dulsaragimhana/Smart-Timetable/Hardware Design/PCB/LCD/3D/Module 20x4 LCD Display PIN Configuration,Commands,Black on White.jpg

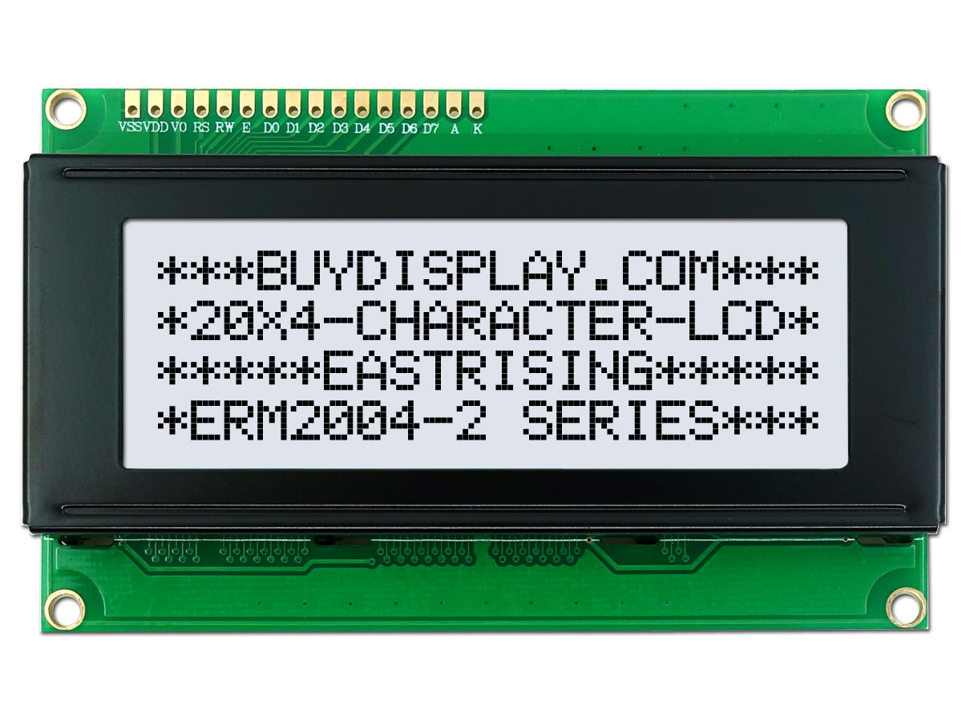
Hardware Design/PCB/LCD/3D/Module 20x4 LCD Display PIN Configuration,Commands,Black on White.jpg
