dulsaragimhana/Smart-Timetable/Hardware Design/PCB/LCD/3D/LCD Module 20x4 Display Datasheet Character,HD44780,Black on YG.jpg

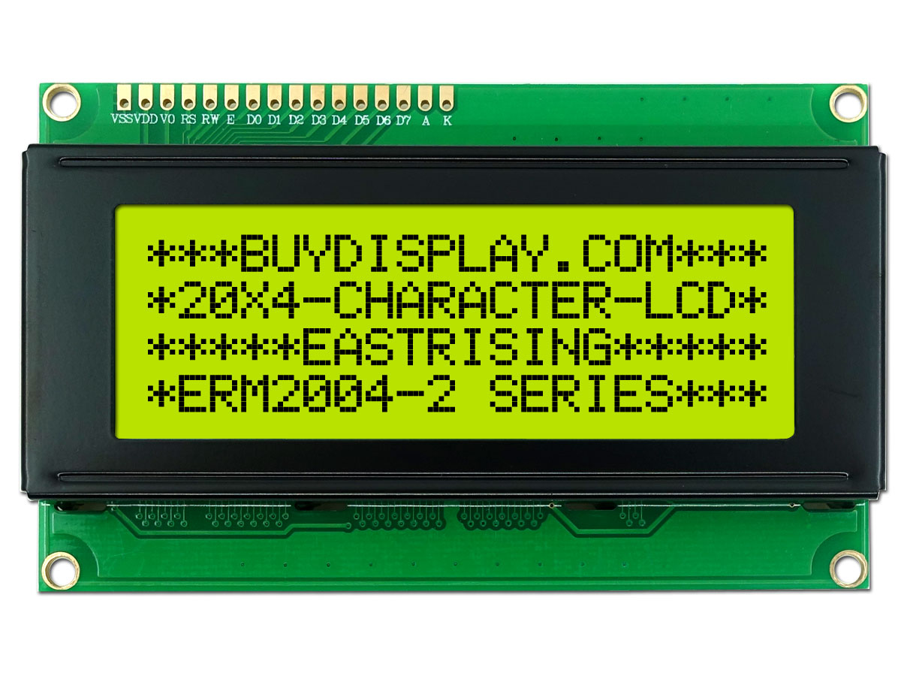
Hardware Design/PCB/LCD/3D/LCD Module 20x4 Display Datasheet Character,HD44780,Black on YG.jpg
