dulsaragimhana/Smart-Timetable/README.md

# Smart-Timetable
An IoT based system to automatically assign teachers to  the free periods. Furthermore, developed it to pass the updated  timetables for the teachers via an SMS and to the classes via an IoT  device.
