dulsaragimhana/Smart-Timetable/Mechanical Design/Readme.txt

Assembly is the file name of our CAD design in above folder
