dulsaragimhana/Smart-Timetable/Hardware Design/Doc/Schematic.jpg

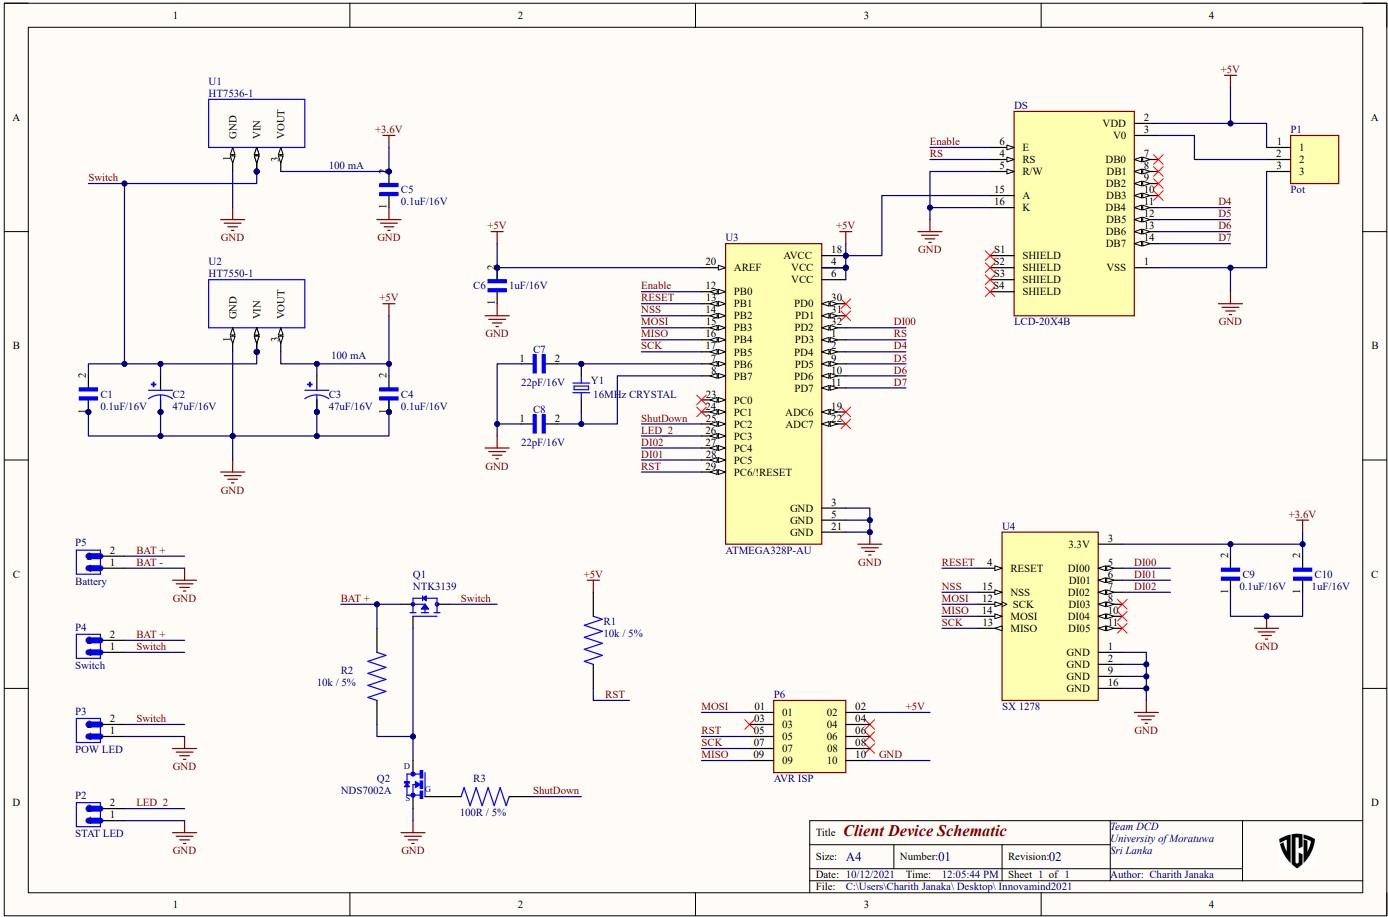
Hardware Design/Doc/Schematic.jpg
