dulsaragimhana/Smart-Timetable/Hardware Design/PCB/LCD/3D/Blue Character Display 20x4 LCD Module,Arduino,White LED Backlight.jpg

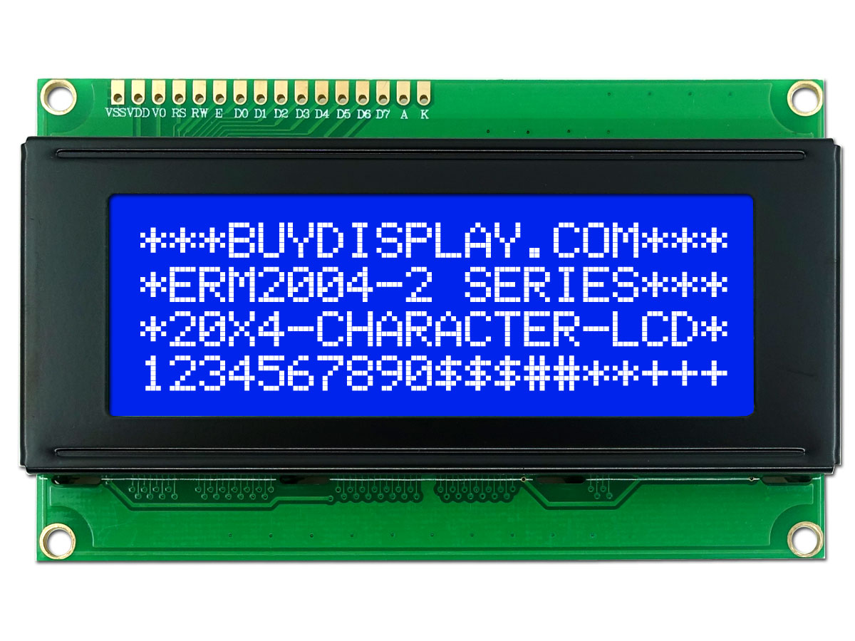
Hardware Design/PCB/LCD/3D/Blue Character Display 20x4 LCD Module,Arduino,White LED Backlight.jpg
