dulsaragimhana/Smart-Timetable/Hardware Design/PCB/LCD/3D/Connect White 20x4 Character Display to I2C Adapter Board with Dupont Wire.jpg

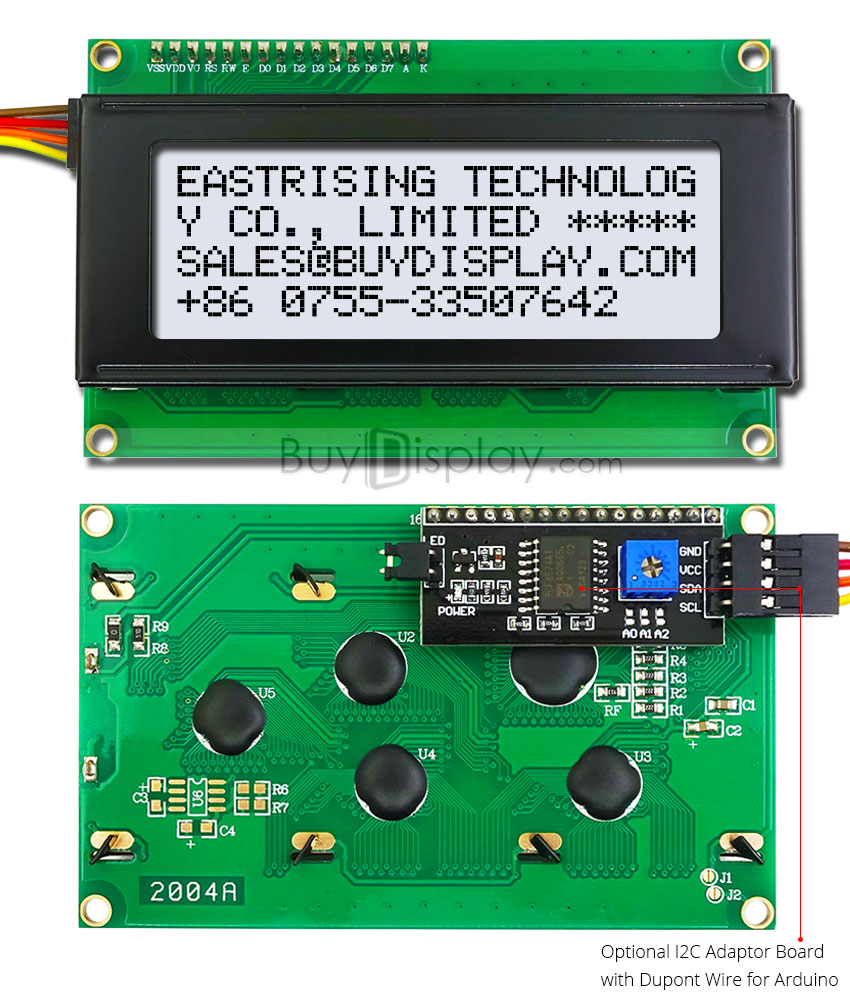
Hardware Design/PCB/LCD/3D/Connect White 20x4 Character Display to I2C Adapter Board with Dupont Wire.jpg
