dulsaragimhana/Smart-Timetable/Hardware Design/PCB/LCD/3D/ERM2004-2_3D Drawing.jpg

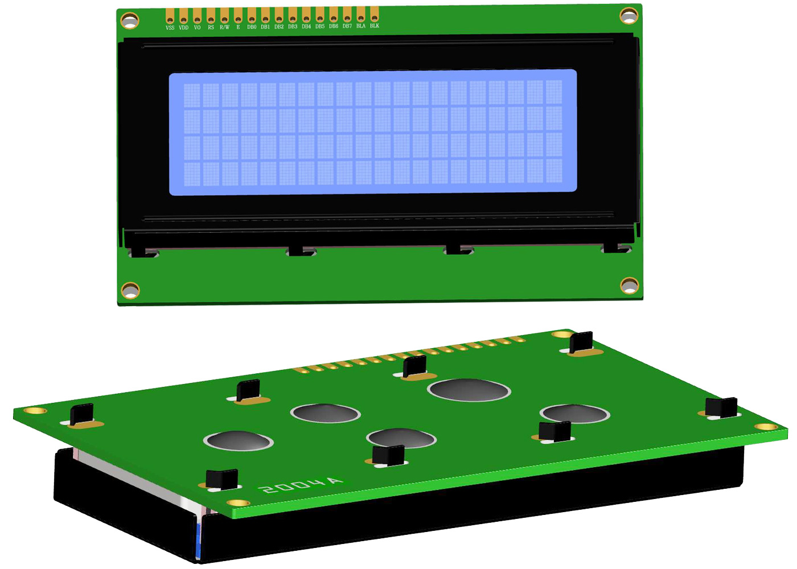
Hardware Design/PCB/LCD/3D/ERM2004-2_3D Drawing.jpg
