dulsaragimhana/Smart-Timetable/Hardware Design/PCB/LCD/3D/ERM2004-2_Bottom_View.jpg

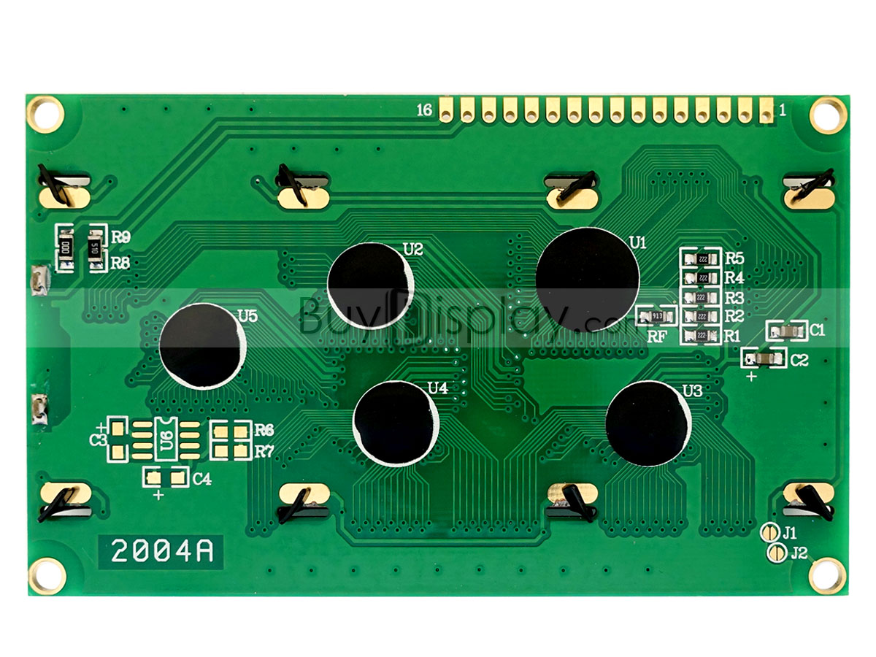
Hardware Design/PCB/LCD/3D/ERM2004-2_Bottom_View.jpg
