dulsaragimhana/Smart-Timetable/Mechanical Design/CAD/Antenna/Antenna1.png

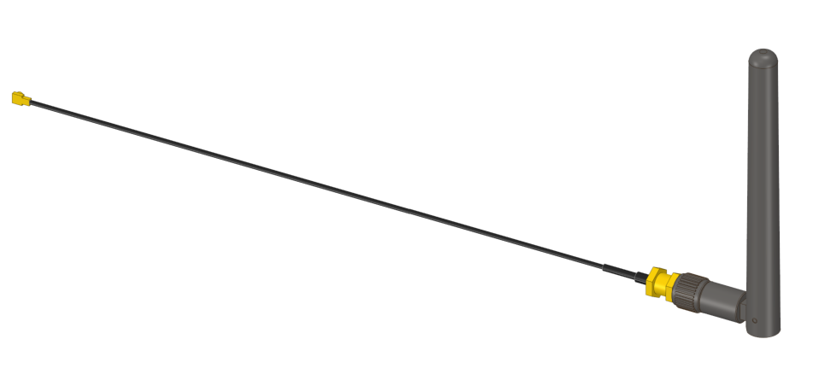
Mechanical Design/CAD/Antenna/Antenna1.png
