dulsaragimhana/Smart-Timetable/Mechanical Design/CAD/Antenna/Antenna2.png

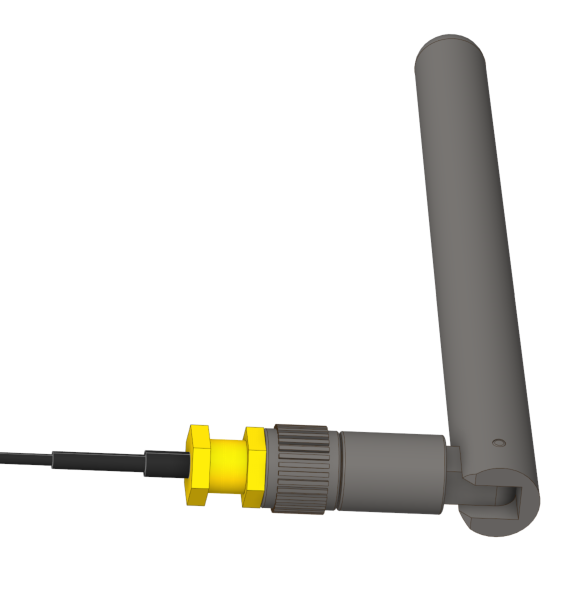
Mechanical Design/CAD/Antenna/Antenna2.png
