dulsaragimhana/Smart-Timetable/Mechanical Design/CAD/Pot2/Renderings/untitled.4.jpg

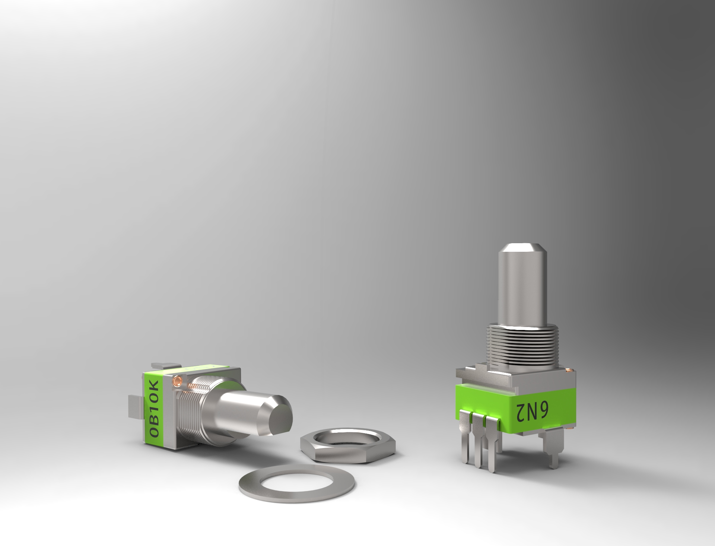
Mechanical Design/CAD/Pot2/Renderings/untitled.4.jpg
