dulsaragimhana/Smart-Timetable/Mechanical Design/CAD/PushButton/PushButton-Red.png

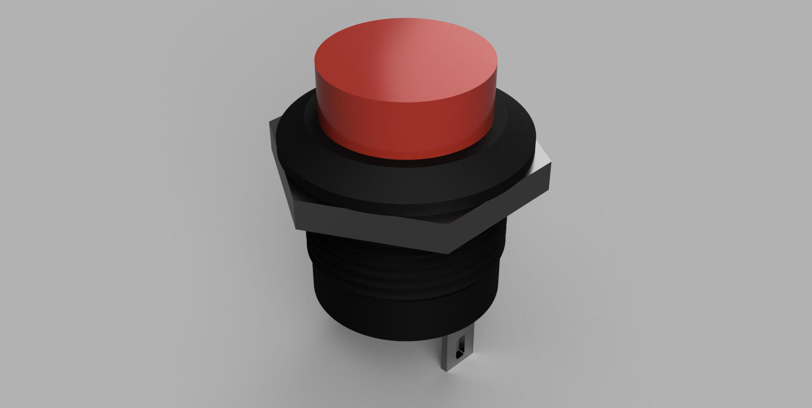
Mechanical Design/CAD/PushButton/PushButton-Red.png
