dulsaragimhana/Smart-Timetable/Hardware Design/PCB/100 Ohm/CRGCQ1206J100R.STEP

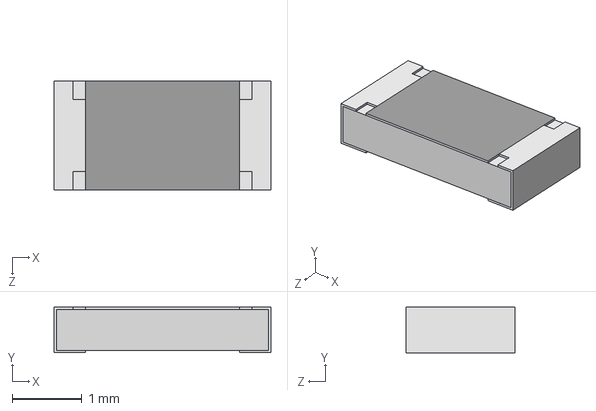
[picture p26: CAD file, 2023-03-04]
Hardware Design/PCB/100 Ohm/CRGCQ1206J100R.STEP
3.10 x 0.65 x 1.55 mm
