dulsaragimhana/Smart-Timetable/Hardware Design/PCB/16MHz/ECS-160-20-5PVX.STEP

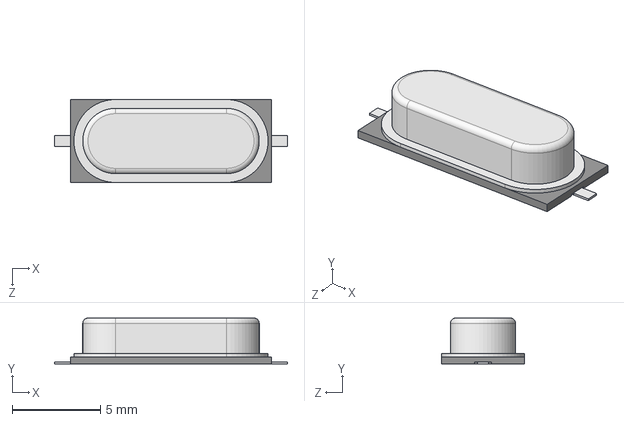
[picture p27: CAD file, 2023-03-04]
Hardware Design/PCB/16MHz/ECS-160-20-5PVX.STEP
13.2 x 2.60 x 4.70 mm
