dulsaragimhana/Smart-Timetable/Hardware Design/PCB/22pF/C1206C220F4HACAUTO.STEP

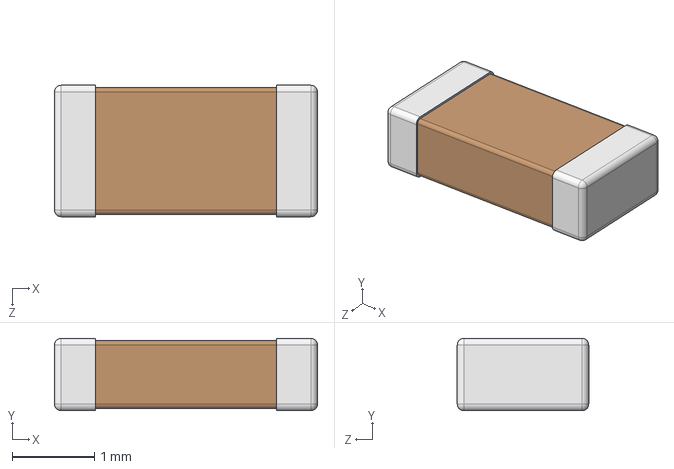
[picture p28: CAD file, 2023-03-04]
Hardware Design/PCB/22pF/C1206C220F4HACAUTO.STEP
3.20 x 0.88 x 1.60 mm
