dulsaragimhana/Smart-Timetable/Hardware Design/PCB/47uF/EEEFC0J470AR.STEP

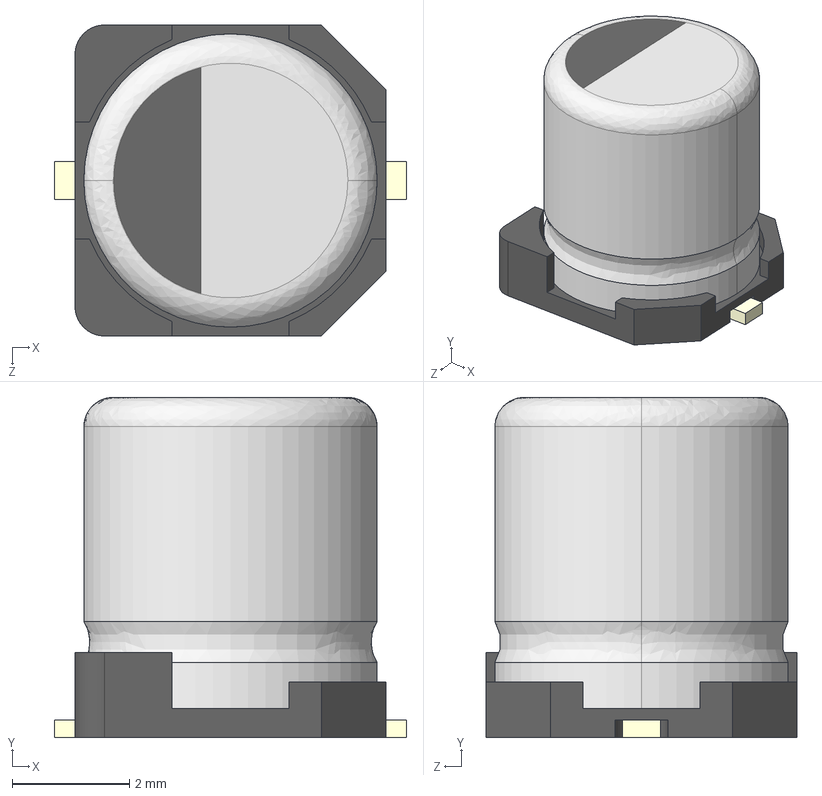
[picture p29: CAD file, 2023-03-04]
Hardware Design/PCB/47uF/EEEFC0J470AR.STEP
6.00 x 5.80 x 5.30 mm
