dulsaragimhana/Smart-Timetable/Hardware Design/PCB/Atmega328P/DIP/ATMEGA328P-PU--3DModel-STEP-56544.STEP

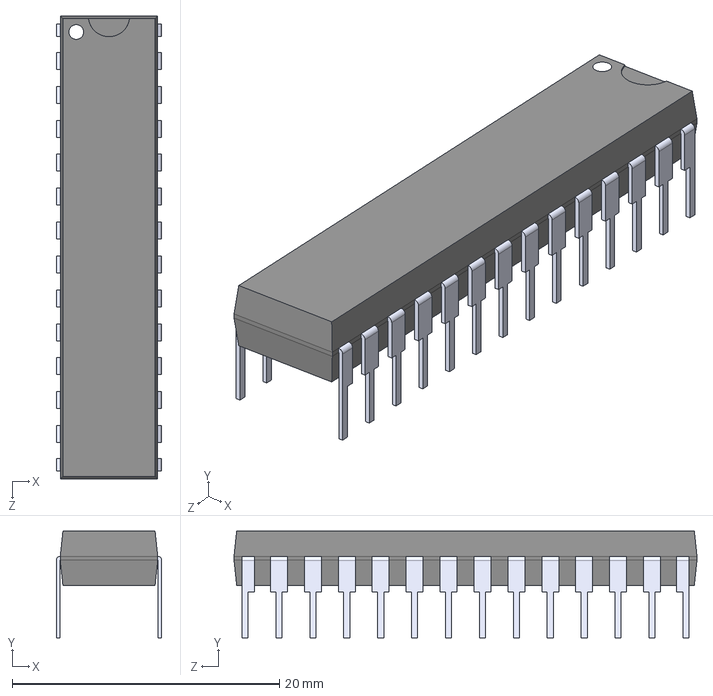
[picture p30: CAD file, 2023-03-04]
Hardware Design/PCB/Atmega328P/DIP/ATMEGA328P-PU--3DModel-STEP-56544.STEP
7.90 x 8.00 x 34.7 mm
