dulsaragimhana/Smart-Timetable/Hardware Design/PCB/Atmega328P/SMD/ATMEGA328P-AU.STEP

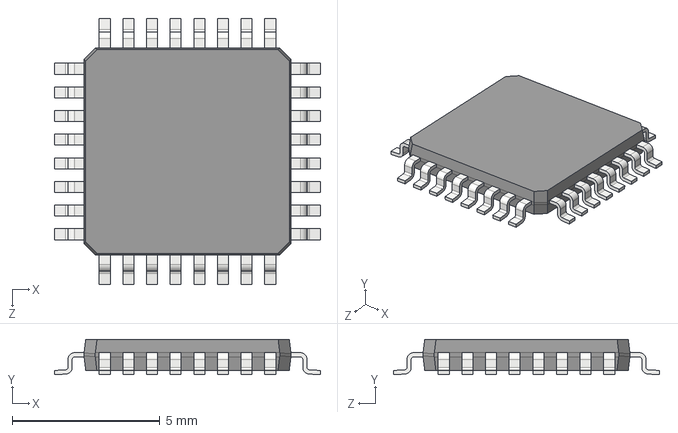
[picture p31: CAD file, 2023-03-04]
Hardware Design/PCB/Atmega328P/SMD/ATMEGA328P-AU.STEP
9.00 x 1.20 x 9.00 mm
