dulsaragimhana/Smart-Timetable/Hardware Design/PCB/Battery/9V_Batterie.STEP

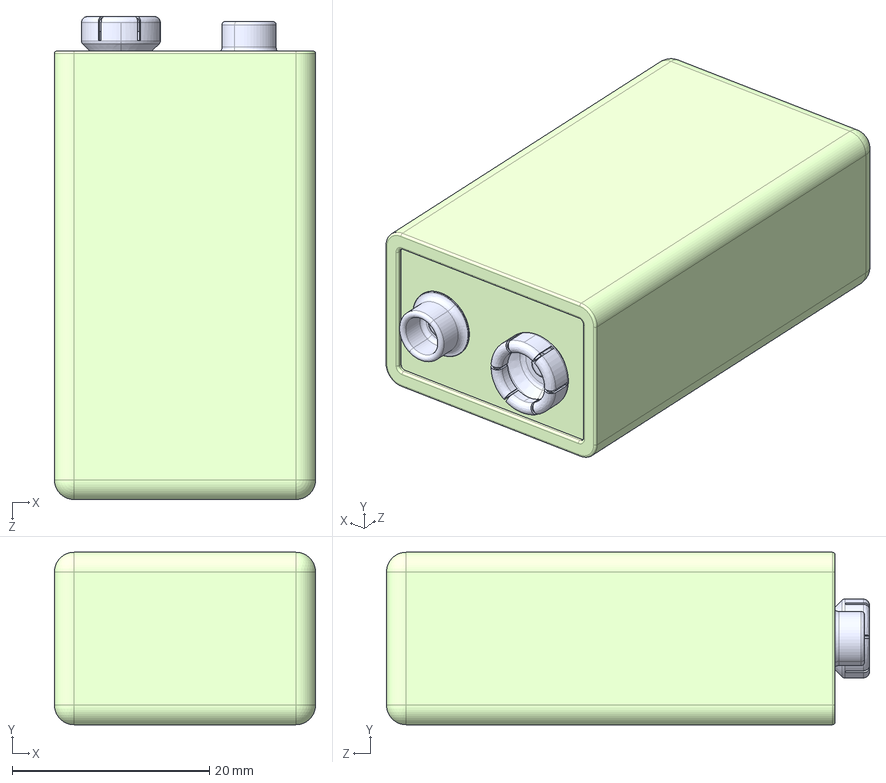
[picture p32: CAD file, 2023-03-04]
Hardware Design/PCB/Battery/9V_Batterie.STEP
26.5 x 17.5 x 49.0 mm
Corps Batterie
Connecteur femelle Batterie 9V
Connecteur male Batterie 9V
