dulsaragimhana/Smart-Timetable/Hardware Design/PCB/Header 2/S2B-XH-A(LF)(SN)--3DModel-STEP-56544.STEP

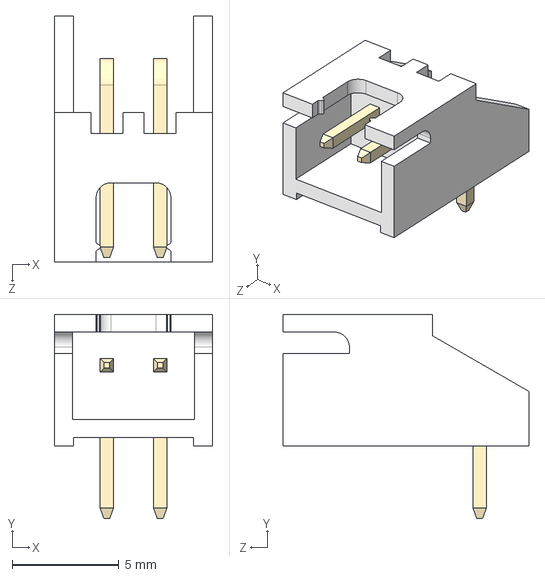
[picture p33: CAD file, 2023-03-04]
Hardware Design/PCB/Header 2/S2B-XH-A(LF)(SN)--3DModel-STEP-56544.STEP
7.40 x 9.55 x 11.5 mm
