dulsaragimhana/Smart-Timetable/Hardware Design/PCB/Header 3/S3B-XH-A-LF--SN---3DModel-STEP-56544.STEP

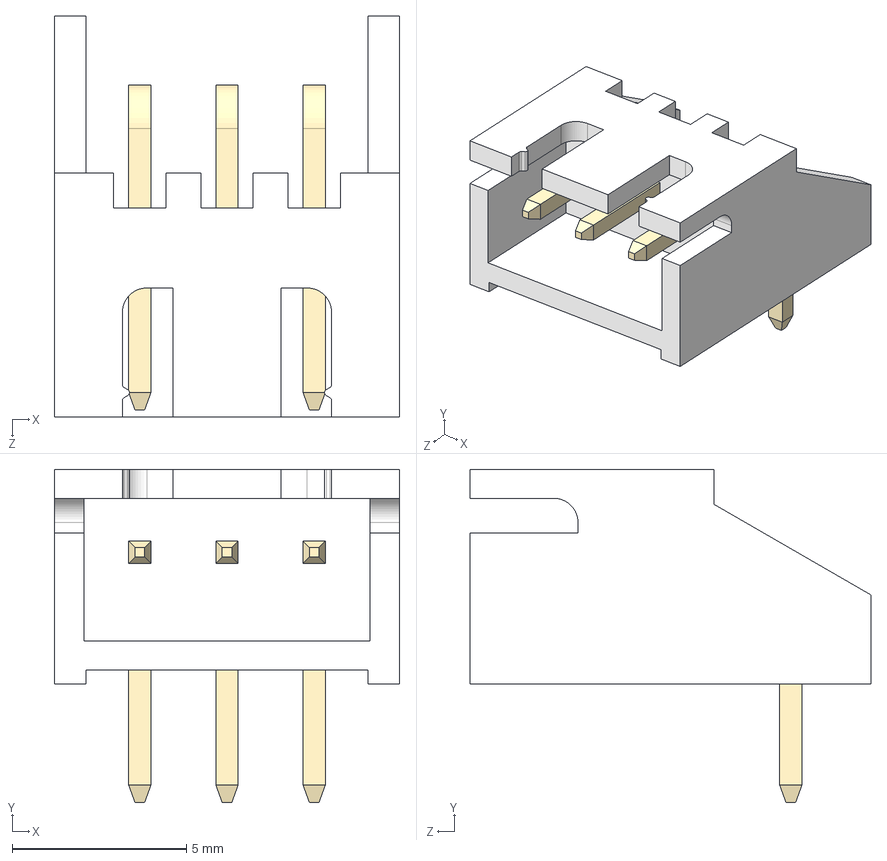
[picture p34: CAD file, 2023-03-04]
Hardware Design/PCB/Header 3/S3B-XH-A-LF--SN---3DModel-STEP-56544.STEP
9.90 x 9.55 x 11.5 mm
