dulsaragimhana/Smart-Timetable/Hardware Design/PCB/HT75xx/SOT-89.STEP

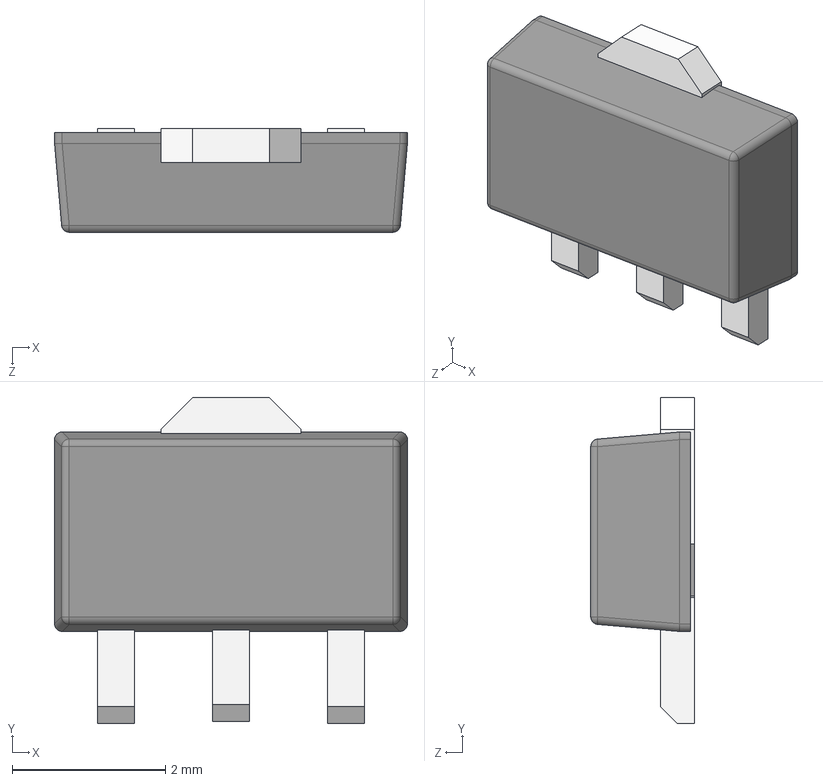
[picture p35: CAD file, 2023-03-04]
Hardware Design/PCB/HT75xx/SOT-89.STEP
4.60 x 4.25 x 1.35 mm
