dulsaragimhana/Smart-Timetable/Hardware Design/PCB/ISPHeader/TSW-105-05-L-D.STEP

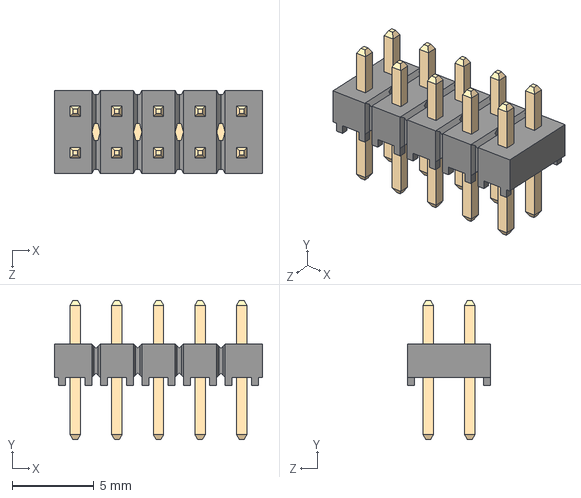
[picture p36: CAD file, 2023-03-04]
Hardware Design/PCB/ISPHeader/TSW-105-05-L-D.STEP
12.7 x 8.51 x 5.08 mm
_TSW-105-05-L-D_body.stp
_T-1S6-21-TSW-1-05-5-D.stp
