dulsaragimhana/Smart-Timetable/Hardware Design/PCB/LCD/lcd20x4hd44780.stp

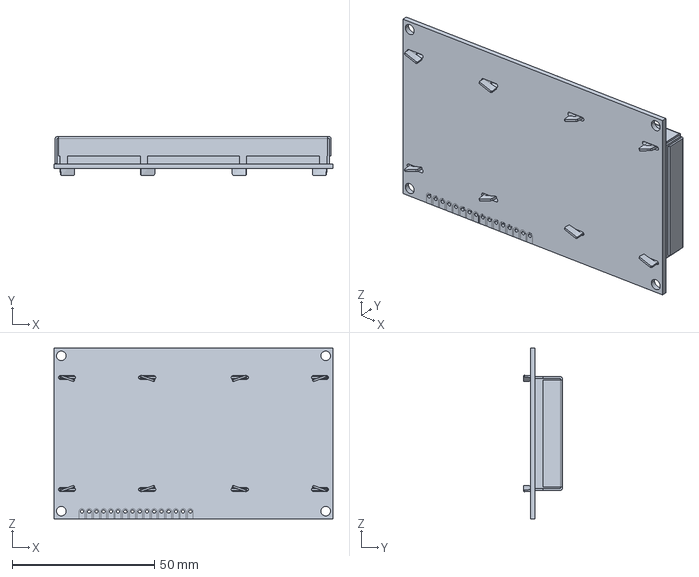
[picture p37: CAD file, 2023-03-04]
Hardware Design/PCB/LCD/lcd20x4hd44780.stp
98.1 x 13.7 x 59.9 mm
