dulsaragimhana/Smart-Timetable/Hardware Design/PCB/LCDHeader/SSW-116-22-G-S.STEP

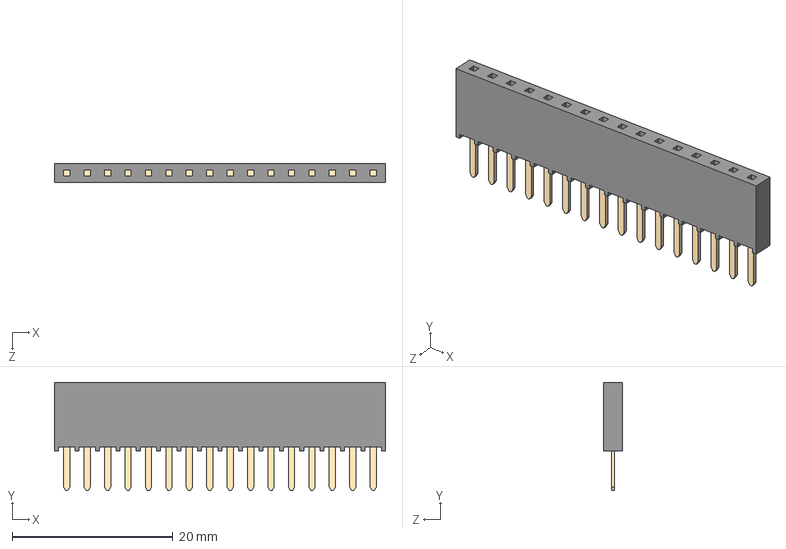
[picture p38: CAD file, 2023-03-04]
Hardware Design/PCB/LCDHeader/SSW-116-22-G-S.STEP
41.1 x 13.4 x 2.41 mm
_T1SSW-116-22-G-S.stp
_P2SSW-116-22-G-S.stp
