dulsaragimhana/Smart-Timetable/Hardware Design/PCB/LoRa 02/LoRa_Module_RA-02_AiThinker.step

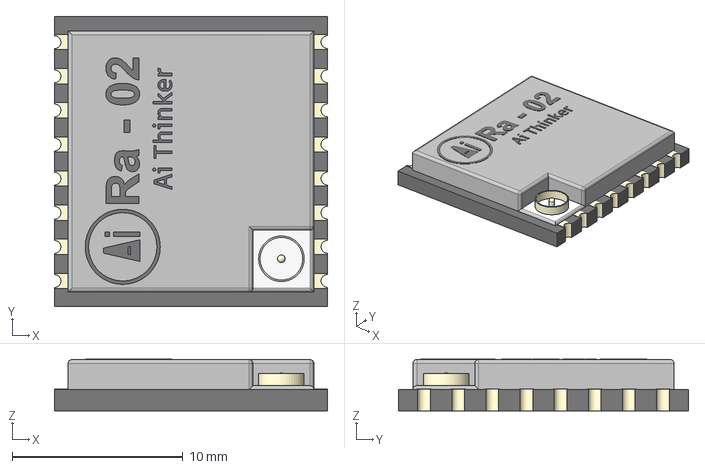
[picture p39: CAD file, 2023-03-04]
Hardware Design/PCB/LoRa 02/LoRa_Module_RA-02_AiThinker.step
16.0 x 17.0 x 3.03 mm
