dulsaragimhana/Smart-Timetable/Hardware Design/PCB/NMos/NDS7002A.STEP

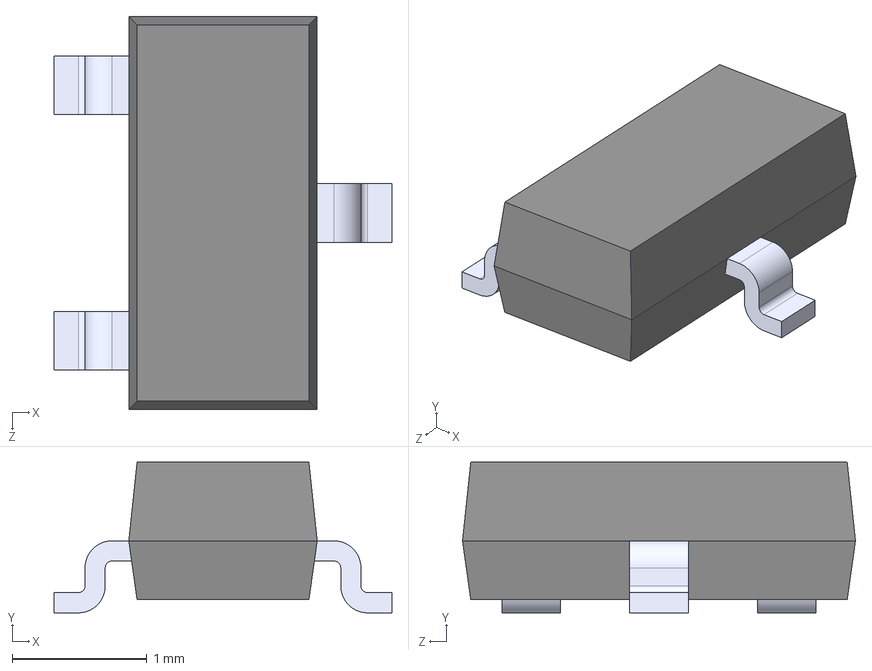
[picture p40: CAD file, 2023-03-04]
Hardware Design/PCB/NMos/NDS7002A.STEP
2.51 x 1.12 x 2.92 mm
