dulsaragimhana/Smart-Timetable/Hardware Design/PCB/PMos/IRF9540/IRF9540NSTRLPBF.STEP

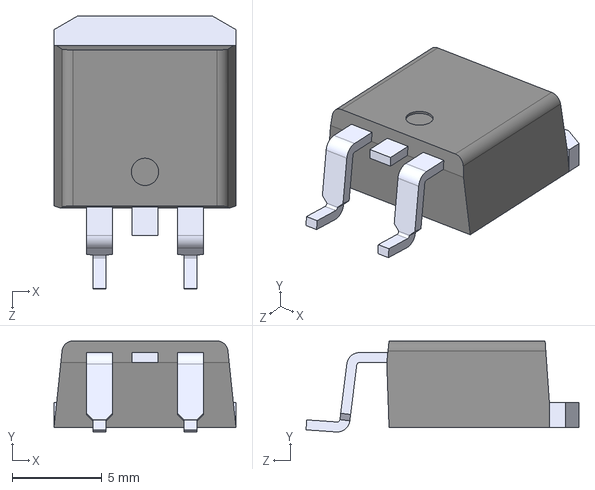
[picture p41: CAD file, 2023-03-04]
Hardware Design/PCB/PMos/IRF9540/IRF9540NSTRLPBF.STEP
10.2 x 5.08 x 15.2 mm
