dulsaragimhana/Smart-Timetable/Hardware Design/PCB/PMos/NTK3139PT1G.STEP

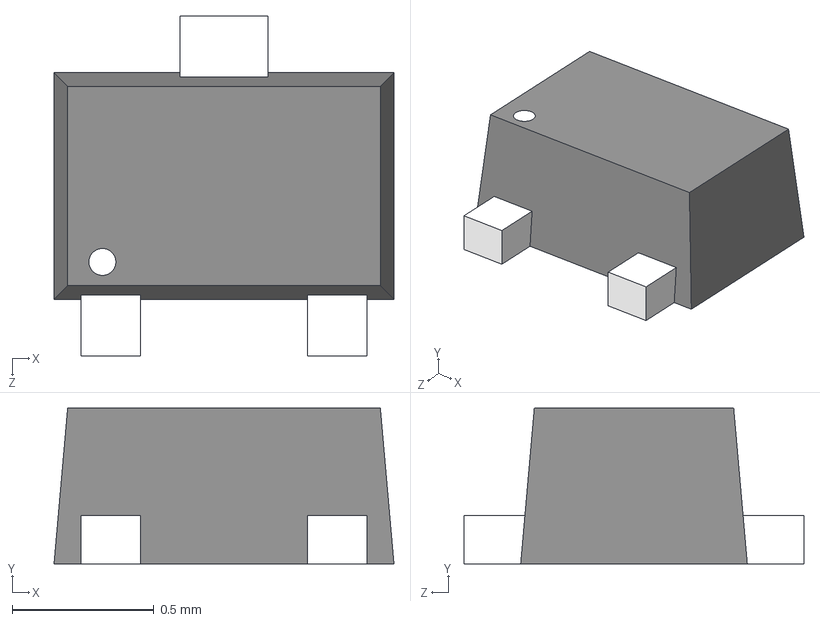
[picture p42: CAD file, 2023-03-04]
Hardware Design/PCB/PMos/NTK3139PT1G.STEP
1.20 x 0.55 x 1.20 mm
