dulsaragimhana/Smart-Timetable/Hardware Design/PCB/Switch/1101M2S3CQE2--3DModel-STEP-56544.STEP

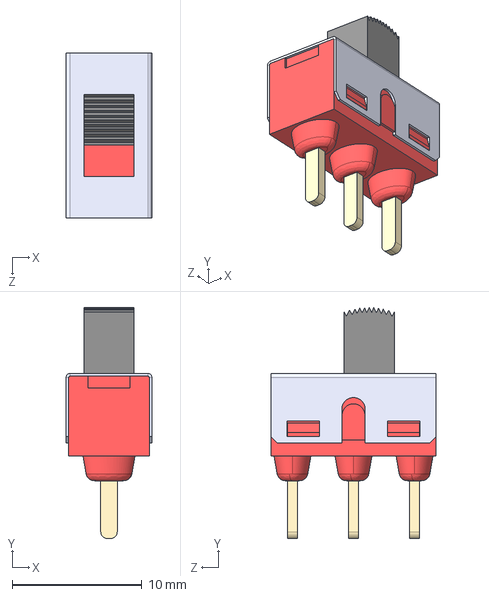
[picture p43: CAD file, 2023-03-04]
Hardware Design/PCB/Switch/1101M2S3CQE2--3DModel-STEP-56544.STEP
6.60 x 17.8 x 12.7 mm
