dulsaragimhana/Smart-Timetable/Mechanical Design/CAD/Antenna/Raspberry Pi CM4 Antenna.stp

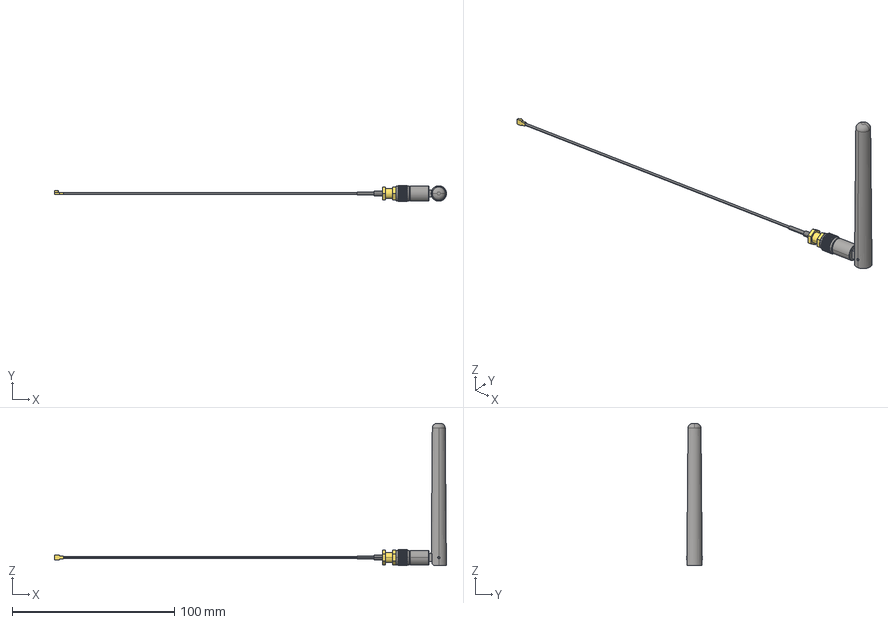
[picture p44: CAD file, 2023-03-04]
Mechanical Design/CAD/Antenna/Raspberry Pi CM4 Antenna.stp
241.5 x 10.0 x 87.7 mm
Antenna body
Antenna base
Threads
Bolt Geometry
Nut
Cable
Coax Connector
