dulsaragimhana/Smart-Timetable/Mechanical Design/CAD/BATTERY PACK B/BATTERY PACK BASE.STEP

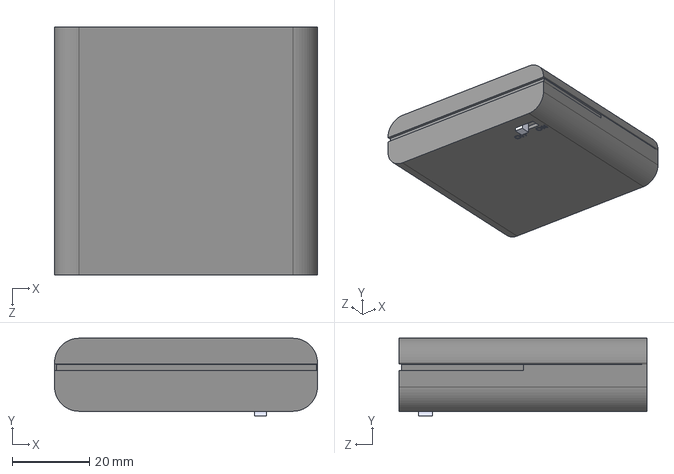
[picture p45: CAD file, 2023-03-04]
Mechanical Design/CAD/BATTERY PACK B/BATTERY PACK BASE.STEP
68.1 x 20.1 x 64.2 mm
