dulsaragimhana/Smart-Timetable/Mechanical Design/CAD/GreenLEDCap.SLDPRT

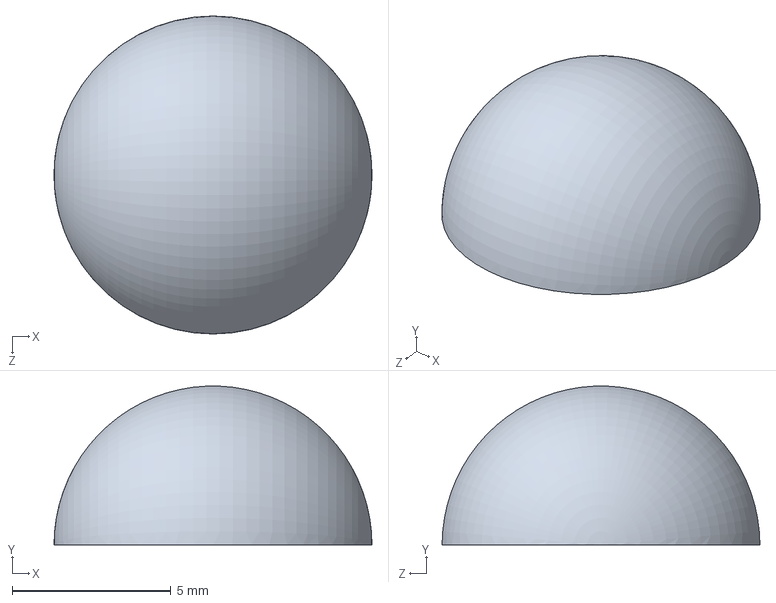
[picture p46: CAD file, 2023-03-04]
Mechanical Design/CAD/GreenLEDCap.SLDPRT
10.0 x 4.99 x 10.0 mm
