dulsaragimhana/Smart-Timetable/Mechanical Design/CAD/LED/LED_D5.0mm_RED.step

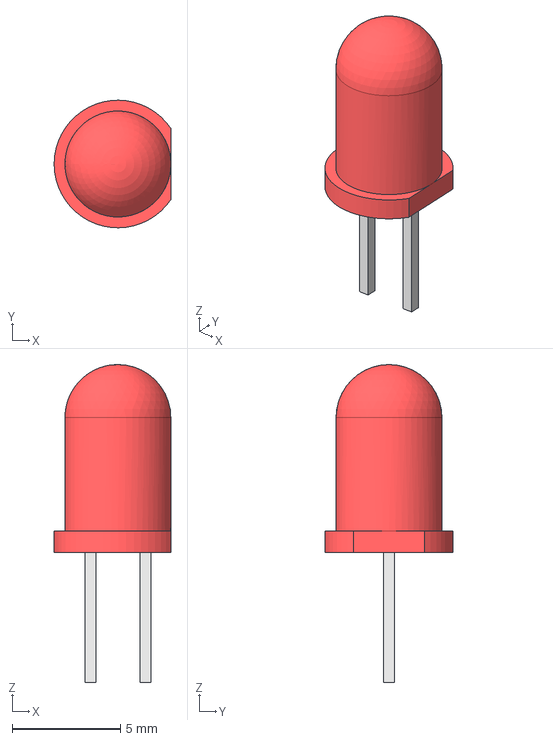
[picture p47: CAD file, 2023-03-04]
Mechanical Design/CAD/LED/LED_D5.0mm_RED.step
5.40 x 5.90 x 14.7 mm
