dulsaragimhana/Smart-Timetable/Mechanical Design/CAD/Pot/PotentiometerB10K.step

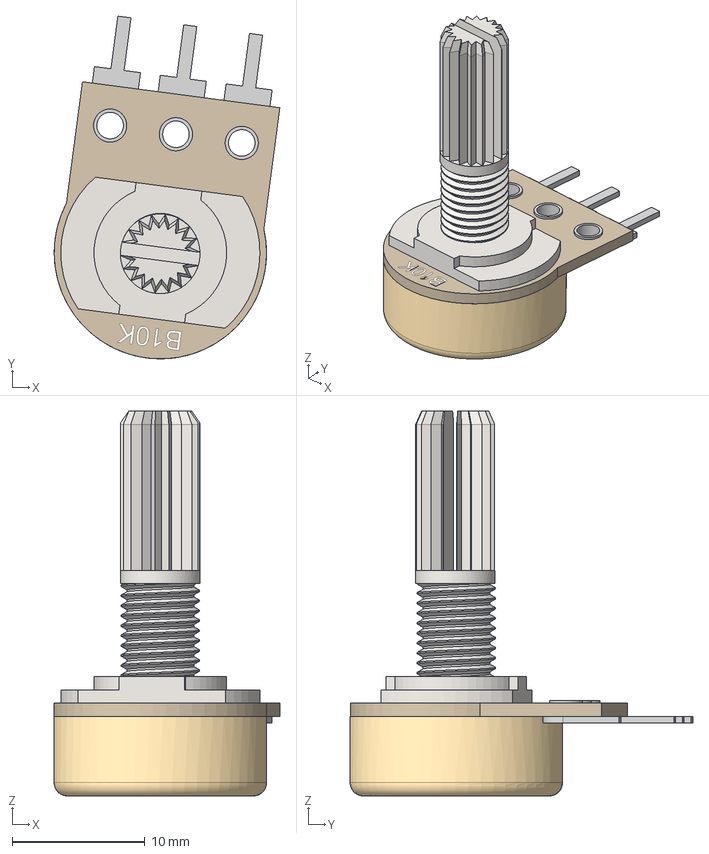
[picture p48: CAD file, 2023-03-04]
Mechanical Design/CAD/Pot/PotentiometerB10K.step
17.0 x 25.8 x 29.0 mm
Shaft
ScrewBase
Board
Pin1
Pin2
Pin3
Casing
