dulsaragimhana/Smart-Timetable/Mechanical Design/CAD/PotKnob/Knob.step

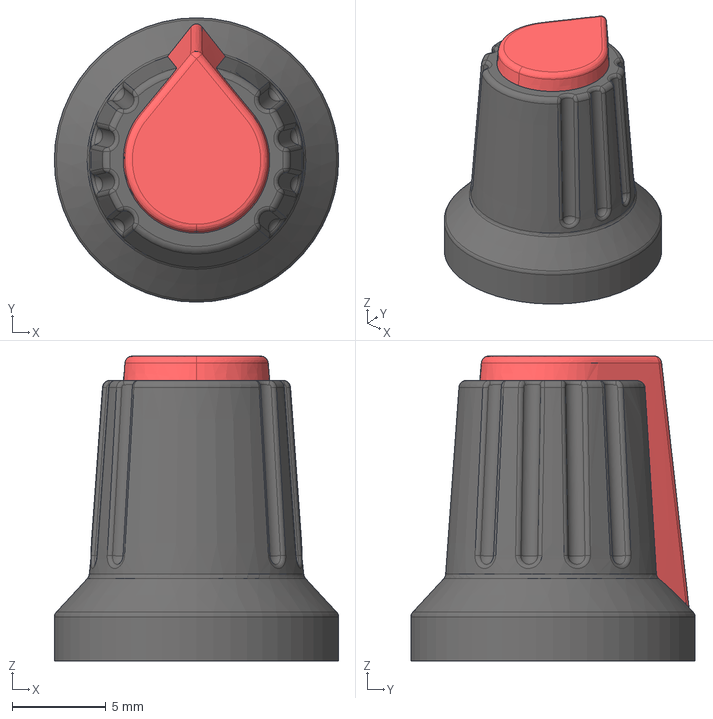
[picture p49: CAD file, 2023-03-04]
Mechanical Design/CAD/PotKnob/Knob.step
15.2 x 15.2 x 16.3 mm
Rouge
Extérieur
