dulsaragimhana/Smart-Timetable/Mechanical Design/CAD/BATTERY PACK B/BATTERY PACK.STEP

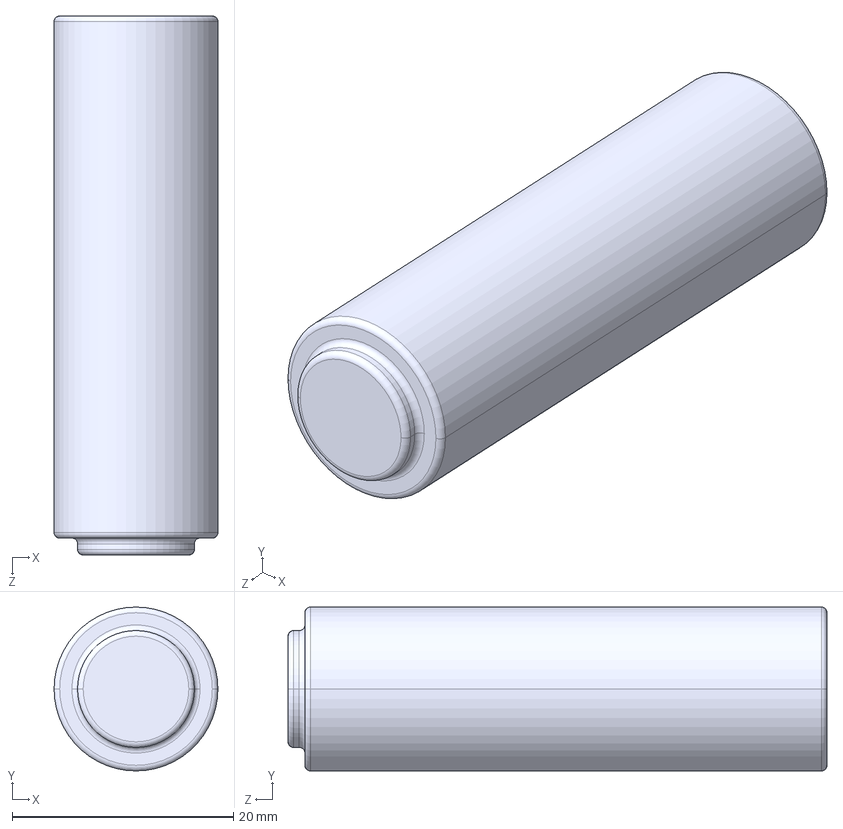
[picture p50: CAD file, 2023-03-04]
Mechanical Design/CAD/BATTERY PACK B/BATTERY PACK.STEP
14.8 x 14.8 x 48.7 mm
