dulsaragimhana/Smart-Timetable/Mechanical Design/CAD/PushButton/PushButtonRed v8.step

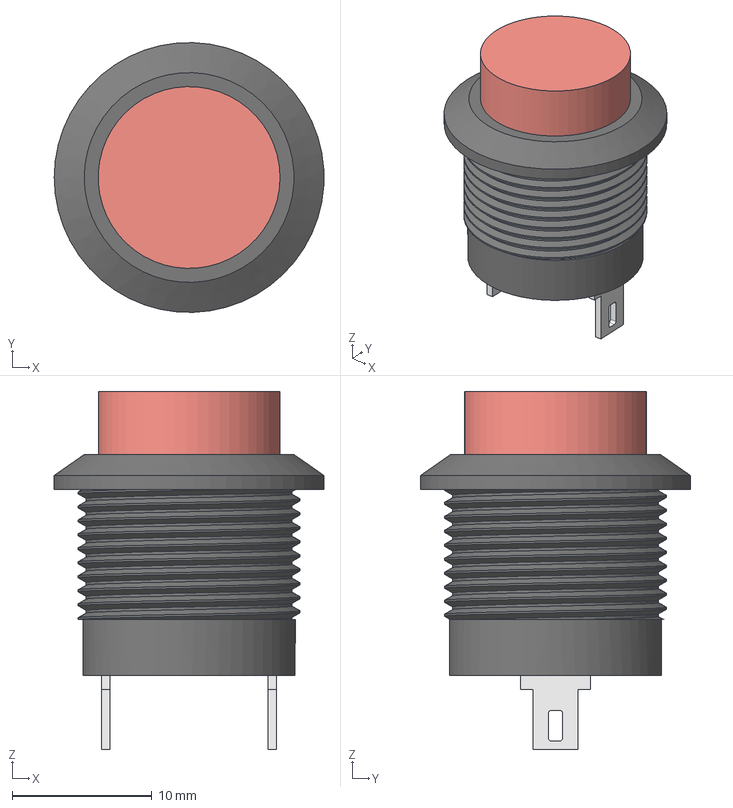
[picture p51: CAD file, 2023-03-04]
Mechanical Design/CAD/PushButton/PushButtonRed v8.step
19.3 x 19.3 x 25.6 mm
ButtonBody
Button
Connector x 2
