dulsaragimhana/Smart-Timetable/Mechanical Design/CAD/BATTERY PACK B/BATTERY PACK COVER.STEP

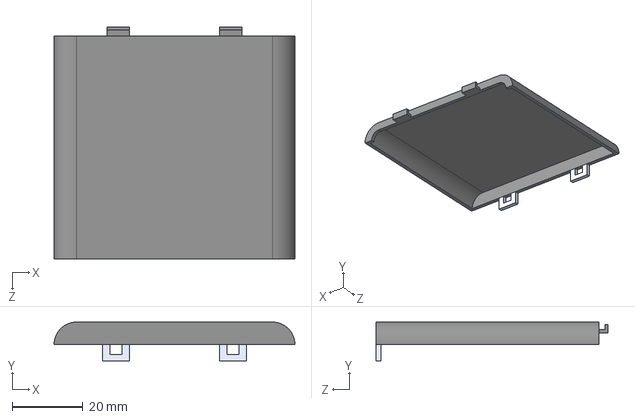
[picture p52: CAD file, 2023-03-04]
Mechanical Design/CAD/BATTERY PACK B/BATTERY PACK COVER.STEP
68.1 x 11.0 x 65.5 mm
