dulsaragimhana/Smart-Timetable/Mechanical Design/CAD/M4 x 20mm.step

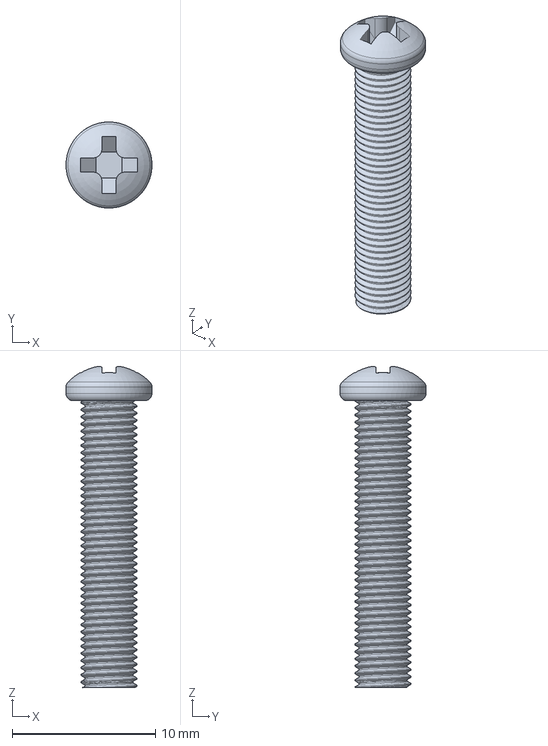
[picture p53: CAD file, 2023-03-04]
Mechanical Design/CAD/M4 x 20mm.step
6.00 x 6.00 x 22.4 mm
