dulsaragimhana/Smart-Timetable/Mechanical Design/CAD/Pot2/KA Type Shaft.STEP

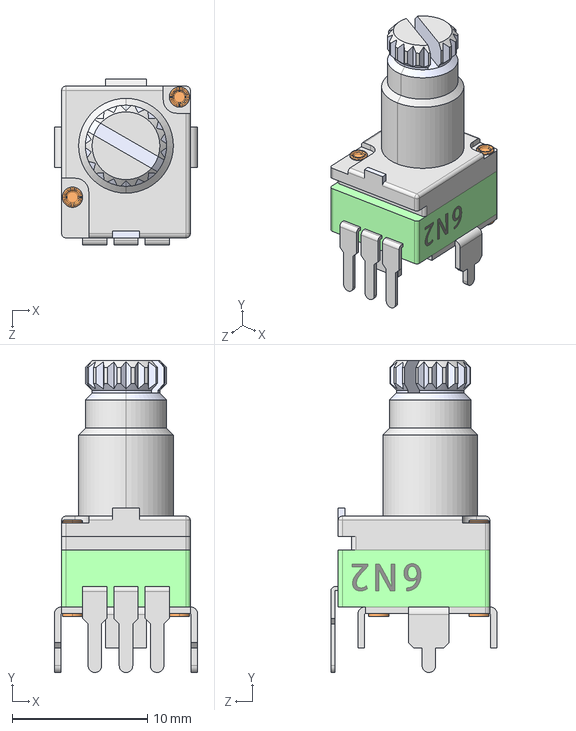
[picture p54: CAD file, 2023-03-04]
Mechanical Design/CAD/Pot2/KA Type Shaft.STEP
10.6 x 23.1 x 12.3 mm
