dulsaragimhana/Smart-Timetable/Mechanical Design/CAD/PushButton/PushButtonRed-WithNut.step

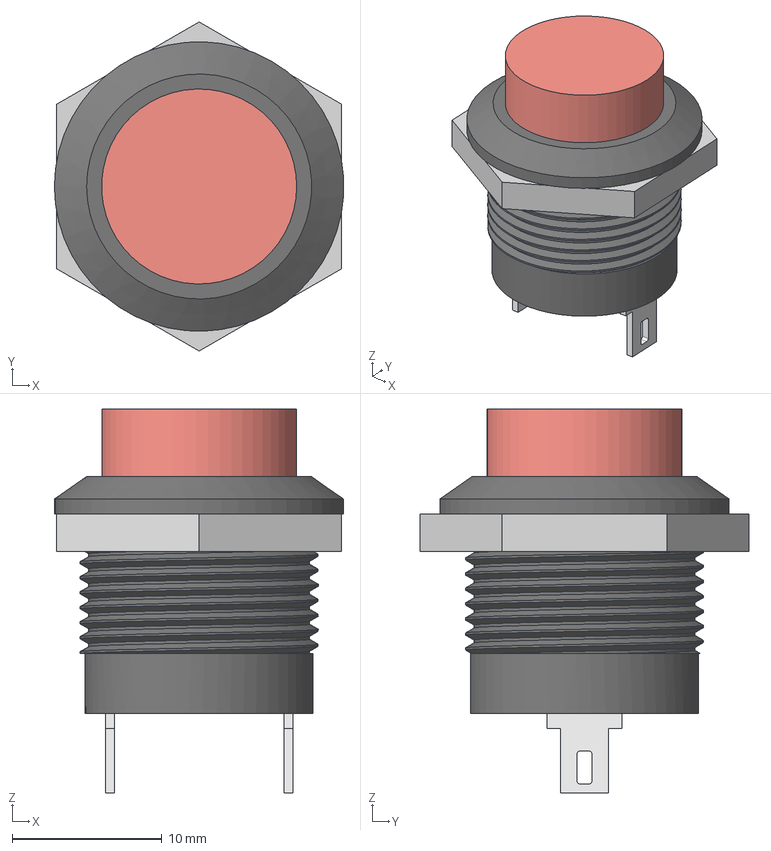
[picture p55: CAD file, 2023-03-04]
Mechanical Design/CAD/PushButton/PushButtonRed-WithNut.step
19.3 x 21.9 x 25.6 mm
ButtonBody
Button
Connector x 2
Nut
