dulsaragimhana/Smart-Timetable/Mechanical Design/CAD/M4 x 10mm.step

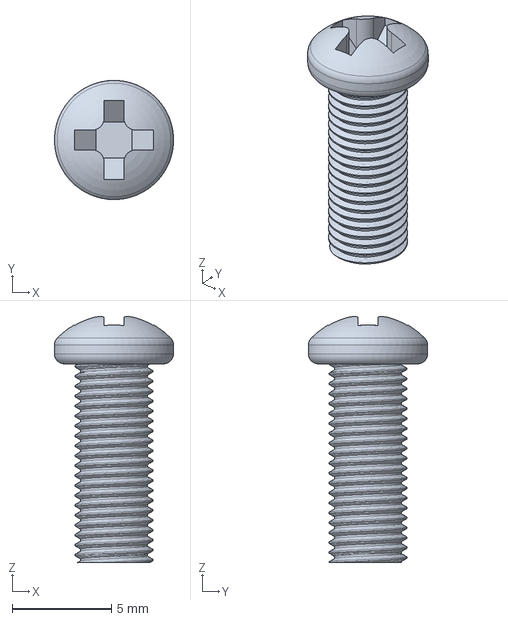
[picture p56: CAD file, 2023-03-04]
Mechanical Design/CAD/M4 x 10mm.step
6.00 x 6.00 x 12.4 mm
