dulsaragimhana/Smart-Timetable/Mechanical Design/CAD/Pot2/Potentiometer.STEP

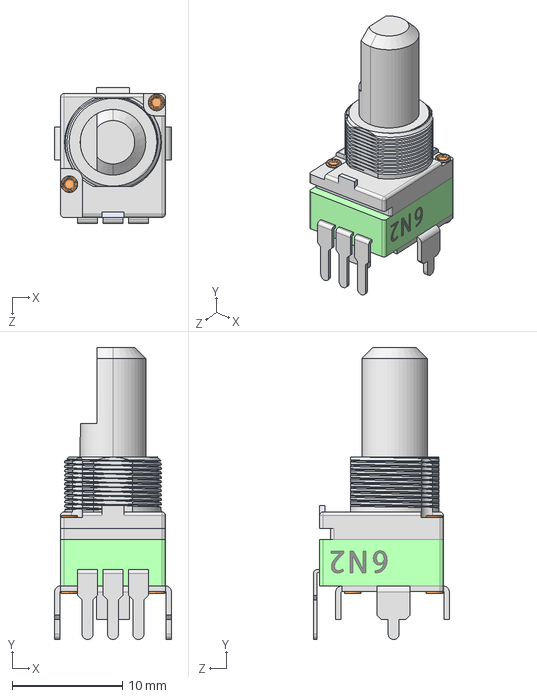
[picture p57: CAD file, 2023-03-04]
Mechanical Design/CAD/Pot2/Potentiometer.STEP
10.6 x 26.5 x 12.3 mm
