dulsaragimhana/Smart-Timetable/Mechanical Design/CAD/BatteryCover.SLDPRT

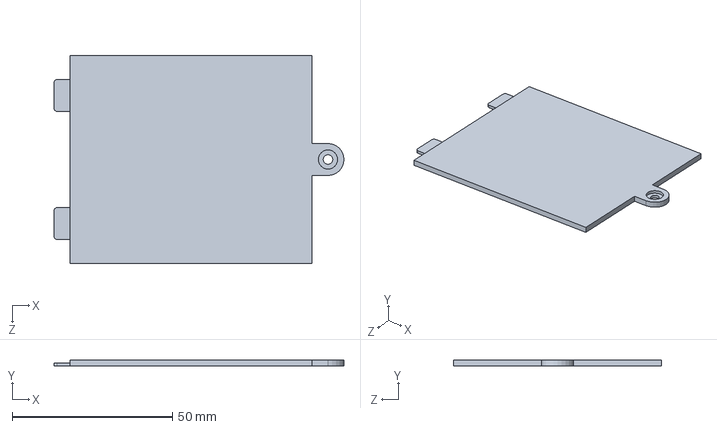
[picture p58: CAD file, 2023-03-04]
Mechanical Design/CAD/BatteryCover.SLDPRT
90.5 x 2.00 x 64.8 mm
