dulsaragimhana/Smart-Timetable/Mechanical Design/CAD/FrontFace.SLDPRT

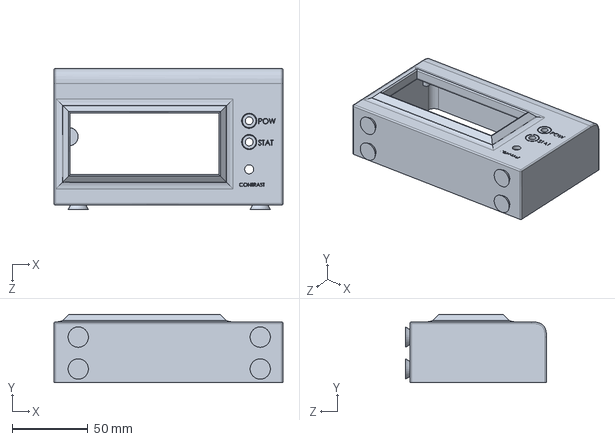
[picture p59: CAD file, 2023-03-04]
Mechanical Design/CAD/FrontFace.SLDPRT
151.0 x 45.0 x 93.0 mm
