dulsaragimhana/Smart-Timetable/(list of files, cad)

Other CAD files:
Hardware Design/PCB/10k/CRGCQ1206J10K.STEP
Mechanical Design/CAD/LED/LED_D5.0mm_BLUE.step
Mechanical Design/CAD/RedLEDCap.SLDPRT
Mechanical Design/CAD/LED/LED_D5.0mm_GREEN.step
Mechanical Design/CAD/LED/LED_D5.0mm_ORANGE.step
Mechanical Design/CAD/LED/LED_D5.0mm_CLEAR.step
Mechanical Design/CAD/LED/LED_D5.0mm_WHITE.step
Mechanical Design/CAD/LED/LED_D5.0mm_YELLOW.step
Hardware Design/PCB/ISPHeader/TSW-105-05-L-D.stp
Hardware Design/PCB/LCDHeader/SSW-116-22-G-S.stp
Mechanical Design/CAD/BATTERY PACK B/BATTERY PACK BASE.IGS
Mechanical Design/CAD/BATTERY PACK B/BATTERY PACK BASE.SLDPRT
Mechanical Design/CAD/BATTERY PACK B/BATTERY PACK COVER.IGS
Mechanical Design/CAD/BATTERY PACK B/BATTERY PACK COVER.SLDPRT
Mechanical Design/CAD/BATTERY PACK B/BATTERY PACK COVER.STL
Mechanical Design/CAD/BATTERY PACK B/BATTERY PACK.IGS
Mechanical Design/CAD/BATTERY PACK B/BATTERY PACK.SLDPRT
Mechanical Design/CAD/BATTERY PACK B/BATTERY PACK.STL
Mechanical Design/CAD/Pot/PotentiometerB10K.f3d
Mechanical Design/CAD/Pot/PotentiometerB10K.iges
Mechanical Design/CAD/Pot/PotentiometerB10K.stl
Mechanical Design/CAD/Pot2/KA Type Shaft.SLDPRT
Mechanical Design/CAD/Pot2/Nut.SLDPRT
Mechanical Design/CAD/Pot2/Nut.STEP
Mechanical Design/CAD/Pot2/Potentiometer.IGS
Mechanical Design/CAD/Pot2/Potentiometer.SLDPRT
Mechanical Design/CAD/Pot2/Potentiometer.STL
Mechanical Design/CAD/Pot2/Potentiometer.x_t
Mechanical Design/CAD/Pot2/Washer 9,0 x 14,0 x 0,5.SLDPRT
Mechanical Design/CAD/Pot2/Washer 9,0 x 14,0 x 0,5.STEP
Mechanical Design/CAD/PotKnob/Knob.f3d
Mechanical Design/CAD/PotKnob/Knob.iges
Mechanical Design/CAD/PushButton/PushButtonRed v9.f3d
Mechanical Design/CAD/PushButton/PushButtonRed-Nut.step
