dulsaragimhana/Smart-Timetable/Hardware Design/Doc/Schematic.pdf

# HT7536-1 GND

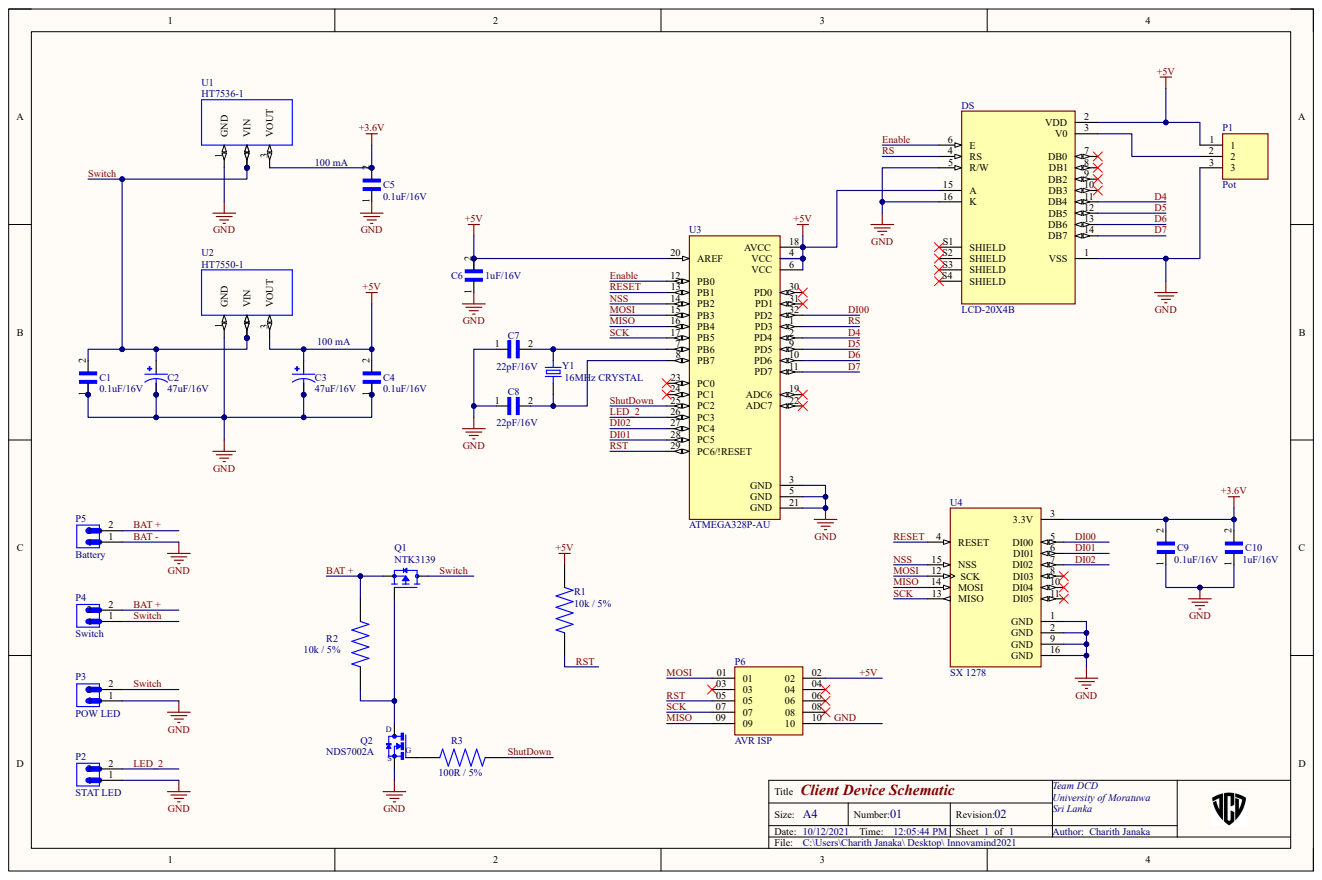
[picture p60: page 1]
