dulsaragimhana/Smart-Timetable/Hardware Design/PCB/InnovaMind2021/InnovaMind2021.pdf

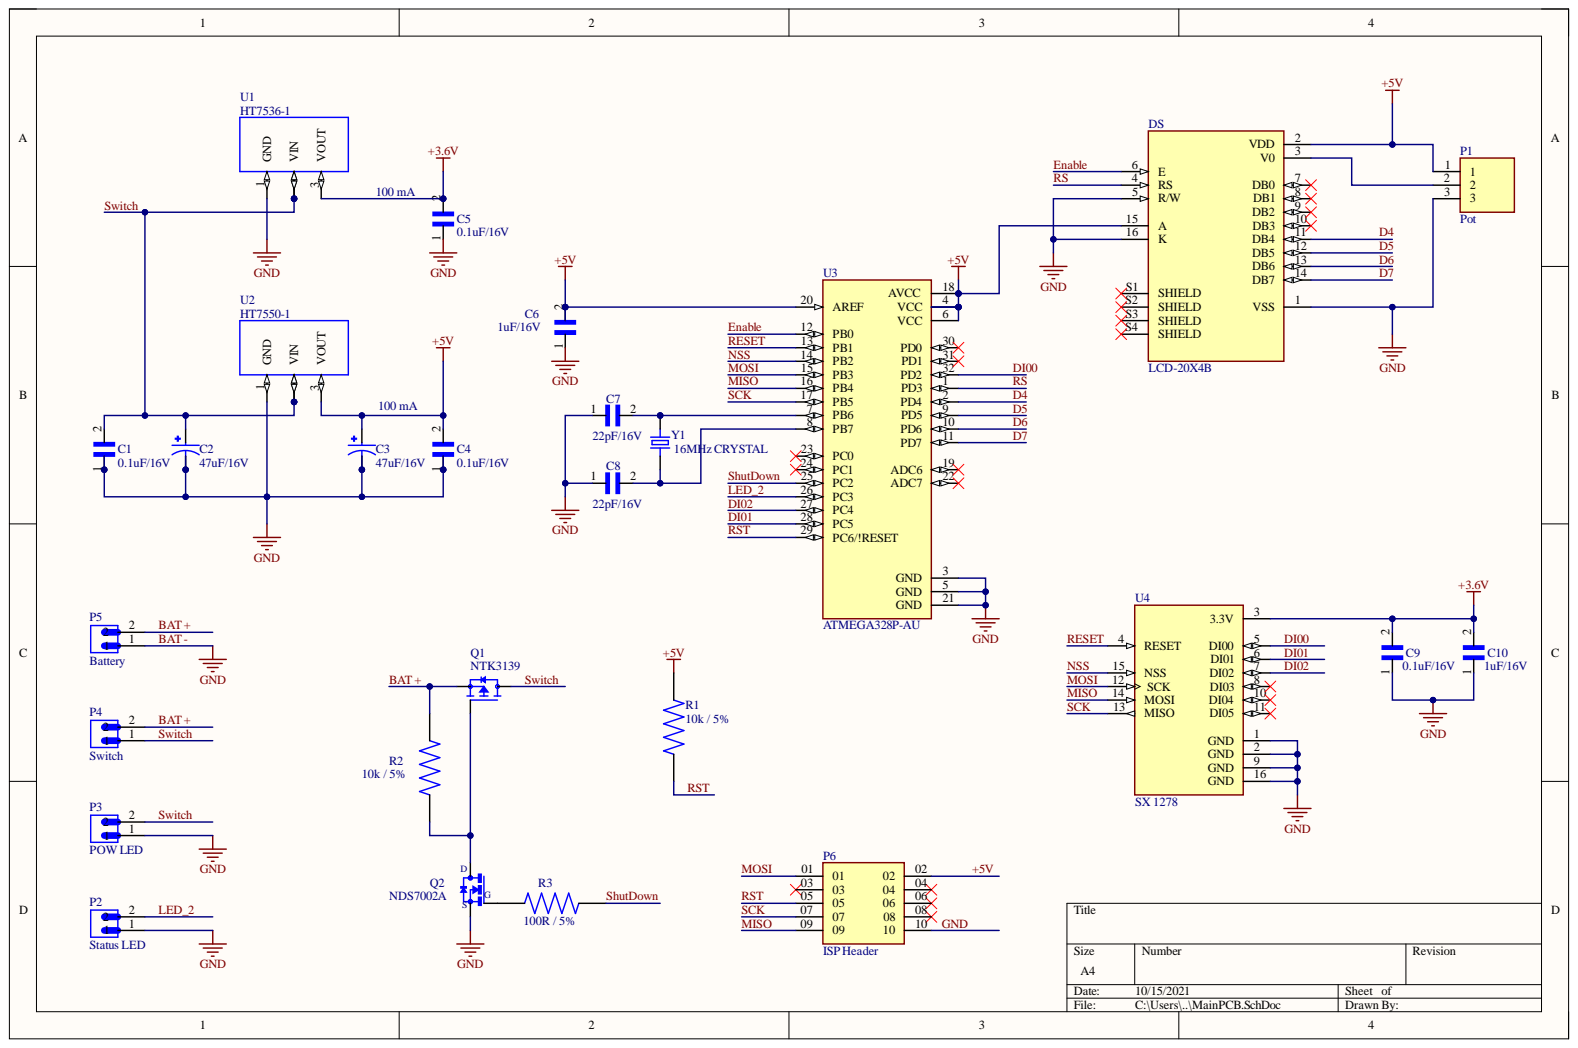
[picture p61: page 1]

Da te : 10/15/20 2 1 | She et of
File : C:\Use rs\. .\MainP C B . S c hD o c | Dr awn By:

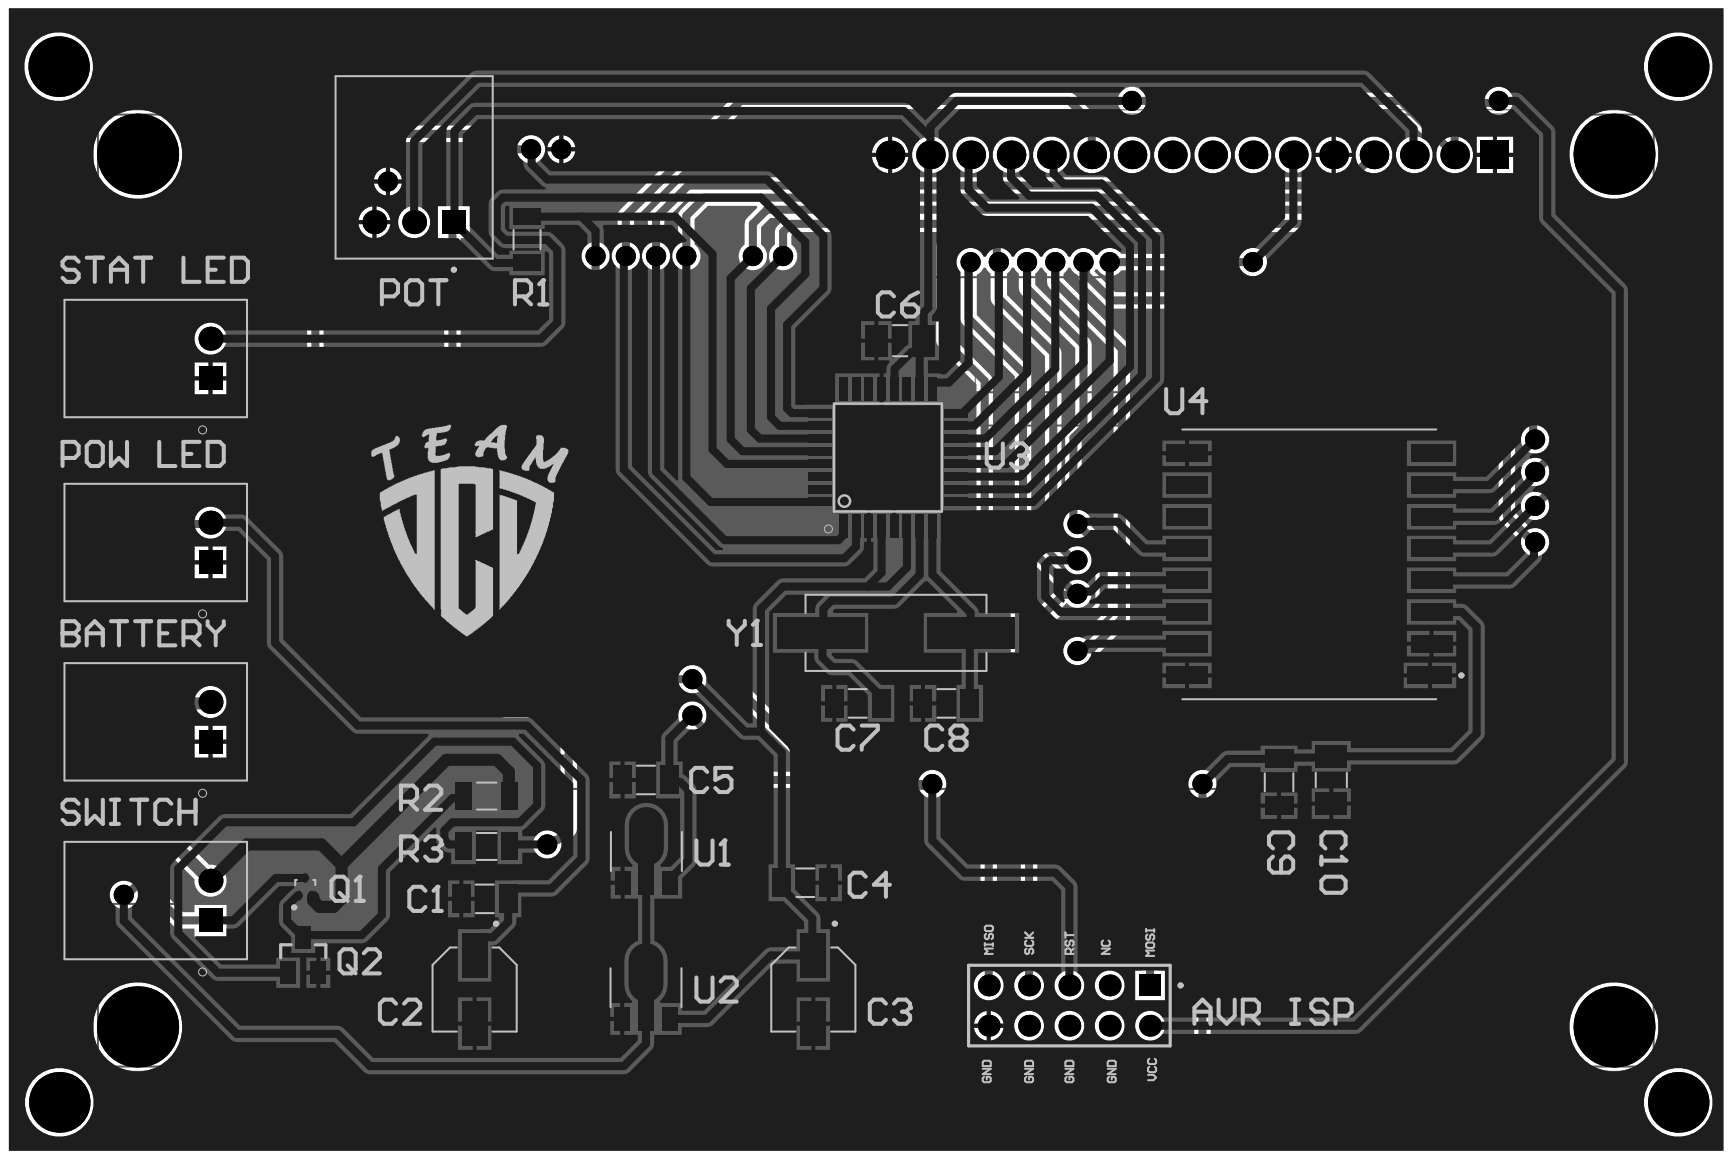
[picture p62: page 2]
