dulsaragimhana/Smart-Timetable/(list of files, drawings)

Other design files:
Hardware Design/PCB/Diode/Miscellaneous Connectors/Miscellaneous Connectors.PcbLib
Hardware Design/PCB/Diode/Miscellaneous Connectors/Miscellaneous Connectors.SchLib
Hardware Design/PCB/InnovaMind2021/InnovaMind2021.PrjPcb
Hardware Design/PCB/InnovaMind2021/Main_Unit.PcbDoc
Hardware Design/PCB/InnovaMind2021/MainPCB.SchDoc
Hardware Design/PCB/LCD/LCD-20X4B/LCD-20X4B.SchLib
Hardware Design/PCB/LCD/LCD-20X4B/LCD_LCD-20X4B.PcbLib
